igorwolfs/modular-adc-hw/docs/board2board/connectors.md

# Connector types
## JLC Lots in stock
### BM22-65-V
Hirose
- Cheap
- Only 6 connections
- Large availability

### Molex 
- https://jlcpcb.com/partdetail/MOLEX-5052704012/C3024406
- Cheap
- 40 pin connections

### What does stm32 use?
- FTR-130-03-L-D-LC (Samtec)
	- 60 pinheaders
- FTR-120-03-L-D-LC (Samtec)
	- 40 pinheaders

### Butterstick
- Samtec - QSE-020-01-F-D-A
