igorwolfs/modular-adc-hw/simulations/ltspice/blocking_adc_frontend_lcr.asc

C1: cap; {C_P}
C2: cap; {C_P}
C3: cap; {C_H}
C4: cap; {C_H}
C5: cap; {C_P}
C6: cap; {C_P}
C7: cap; {C_block}
C9: cap; {C_block}
C10: cap; {C_H}
C11: cap; {C_H}
C12: cap; {C_filter}
C13: cap; {C_block}
C14: cap; {C_block}
C15: cap; {C_P}
C16: cap; {C_P}
C17: cap; {C_H}
C18: cap; {C_H}
C19: cap; {C_filter}
C20: cap; {C_block}
C21: cap; {C_block}
L3: ind; {{L_filter} + 0.05*{L_filter}}
L4: ind; {{L_filter}-0.05*{L_filter}}
L5: ind; {{L_filter} + 0.05*{L_filter}}
L6: ind; {{L_filter}-0.05*{L_filter}}
R1: res; {R_tl}
R2: res; {R_tl}
R3: res; {{R_diff}/2}
R4: res; {R_diff/2}
R5: res; {R_diff/2}
R6: res; {R_div}
R7: res; {R_div}
R8: res; 100e3
R9: res; 100e3
R12: res; 0.01
R13: res; 0.01
R14: res; {{R_diff}/2}
R15: res; {R_tl}
R16: res; {R_tl}
R17: res; {R_diff/2}
R18: res; {R_diff/2}
R19: res; 100e3
R20: res; 100e3
R21: res; 5
R22: res; 5
R23: res; 0.01
R24: res; 0.01
R25: res; {R_tl}
R26: res; {R_tl}
R27: res; {R_diff/2}
R28: res; {R_diff/2}
R29: res; 100e3
R30: res; 100e3
R31: res; 5
R32: res; 5
R33: res; 0.01
R34: res; 0.01
S1: sw; SW1
S2: sw; SW1
S3: sw; SW1
S4: sw; SW1
S5: sw; SW1
S6: sw; SW1
S7: sw; SW1
S8: sw; SW1
S9: sw; SW1
S10: sw; SW1
S11: sw; SW1
S12: sw; SW1
U1: UniversalOpAmp; Avol=1000 GBW=2e20 Vos=0
U2: UniversalOpAmp; Avol=1000 GBW=2e20 Vos=0
U3: UniversalOpAmp; Avol=1000 GBW=2e20 Vos=0
U4: UniversalOpAmp; Avol=1000 GBW=2e20 Vos=0
U5: UniversalOpAmp; Avol=1000 GBW=2e20 Vos=0
U6: UniversalOpAmp; Avol=1000 GBW=2e20 Vos=0
V1: voltage; PULSE(0 3.3 0 2.14e-9 2.14e-9 10e-9 28.57e-9 1e6)
V2: voltage; PULSE(3.3 0 0 2.14e-9 2.14e-9 10e-9 28.57e-9 1e6)
V3: voltage; SINE(0 1.5 1e6 0 0 0 1e6); AC 1 0; Rser=0
V4: voltage; 3.3
Named nets: AIN+, AIN-, 0, V_IN_SW, V_SHA_SW, V_bias, VREF
.param C_P=5e-9 C_H=5e-9 t_rf=2.14e-9 tch=100e-9 C_block=100e-9 R_diff=10 R_tl=1 R_div=4.7e3 L_filter=1pH C_filter=100pF
.tran 0 10e-6 0 1e-10
CLK_LOW:
- SW1, SW2: closed, SW3: open
- Ch is charged
CLK LOW->HIGH:
- SW1, SW2: opened, SW3: closed
- SHA in HOLD mode
a few moments later
- SW3 closed
- Amplifier output == CH voltage
.model SW1 SW(Ron=50 Roff=1e9 Vt=1.5 Vh=0)
Ideal buffering OPAMP 
- SHORT between 2 inputs
- infinite input impedance
Note: in order to buffer a differential signals we need 2 buffers
Input impedance for next stage
.ac oct 1e3 1e3 15e6
NOTES ON DIFFERENTIAL VS SINGLE-ENDED FILTERS
Differential filter
- differential impedance Zd(f) (to differential component: Vd = V+ - V-)
- common mode impedance infinity (to common-mode component (V+ + V-) / 2) 
- So the filter acts purely on the differential mode.
- Ground variations only affect common-mode voltage, not the filtered differential voltage
Single-ended filter
- Filters signal w.r.t. ground -> single-ended signals take this path back to source.
- Stray currents can change the filter's behavior and the line voltage
