igorwolfs/modular-adc-hw/simulations/ltspice/ths4521.asc

C1: cap; {C_FB}
C2: cap; {C_FB}
C3: cap; 0.1µ
R1: res; {R_FRONT}
R2: res; {R_FRONT}
R4: res; {R_LOAD}
R5: res; {R_FB}
R7: res; 100k
R8: res; 100k
R9: res; 50
R10: res; {R_FB}
R11: res; 50
R12: res; {R_OUT}
R13: res; {R_LOAD}
R14: res; {R_OUT}
U1: THS4521
V1: voltage; 1.4
V3: voltage; SINE(0 0.6 1e5 0 0 0 1e6); AC 0.7 0; Rser=0
V4: voltage; 3.3
V6: voltage; 1.45
Named nets: AIN+, AIN-, 0, VREF, VBIAS
.tran 0 1e-5 0 1e-10
.ac oct 1e3 1e3 15e6
.param C_FB=1.5nF R_FB=1k R_FRONT=1k R_OUT=50 C_OUT=2.2nF R_LOAD=100k V_CM=1.45 V_DIFF=0.6
- Input/Output ([Vs-] - 0.7V)-> ([Vs+] + 0.7)
- Vid_max = 1 V
SOURCES:
- Using differential sources in ltspice: https://www.youtube.com/watch?v=o5SBtzoKLpM
