igorwolfs/modular-adc-hw/modular-adc-board/modular-adc-board.kicad_pcb

## KiCad design modular-adc-board/modular-adc-board.kicad_pcb (2025-09-30)

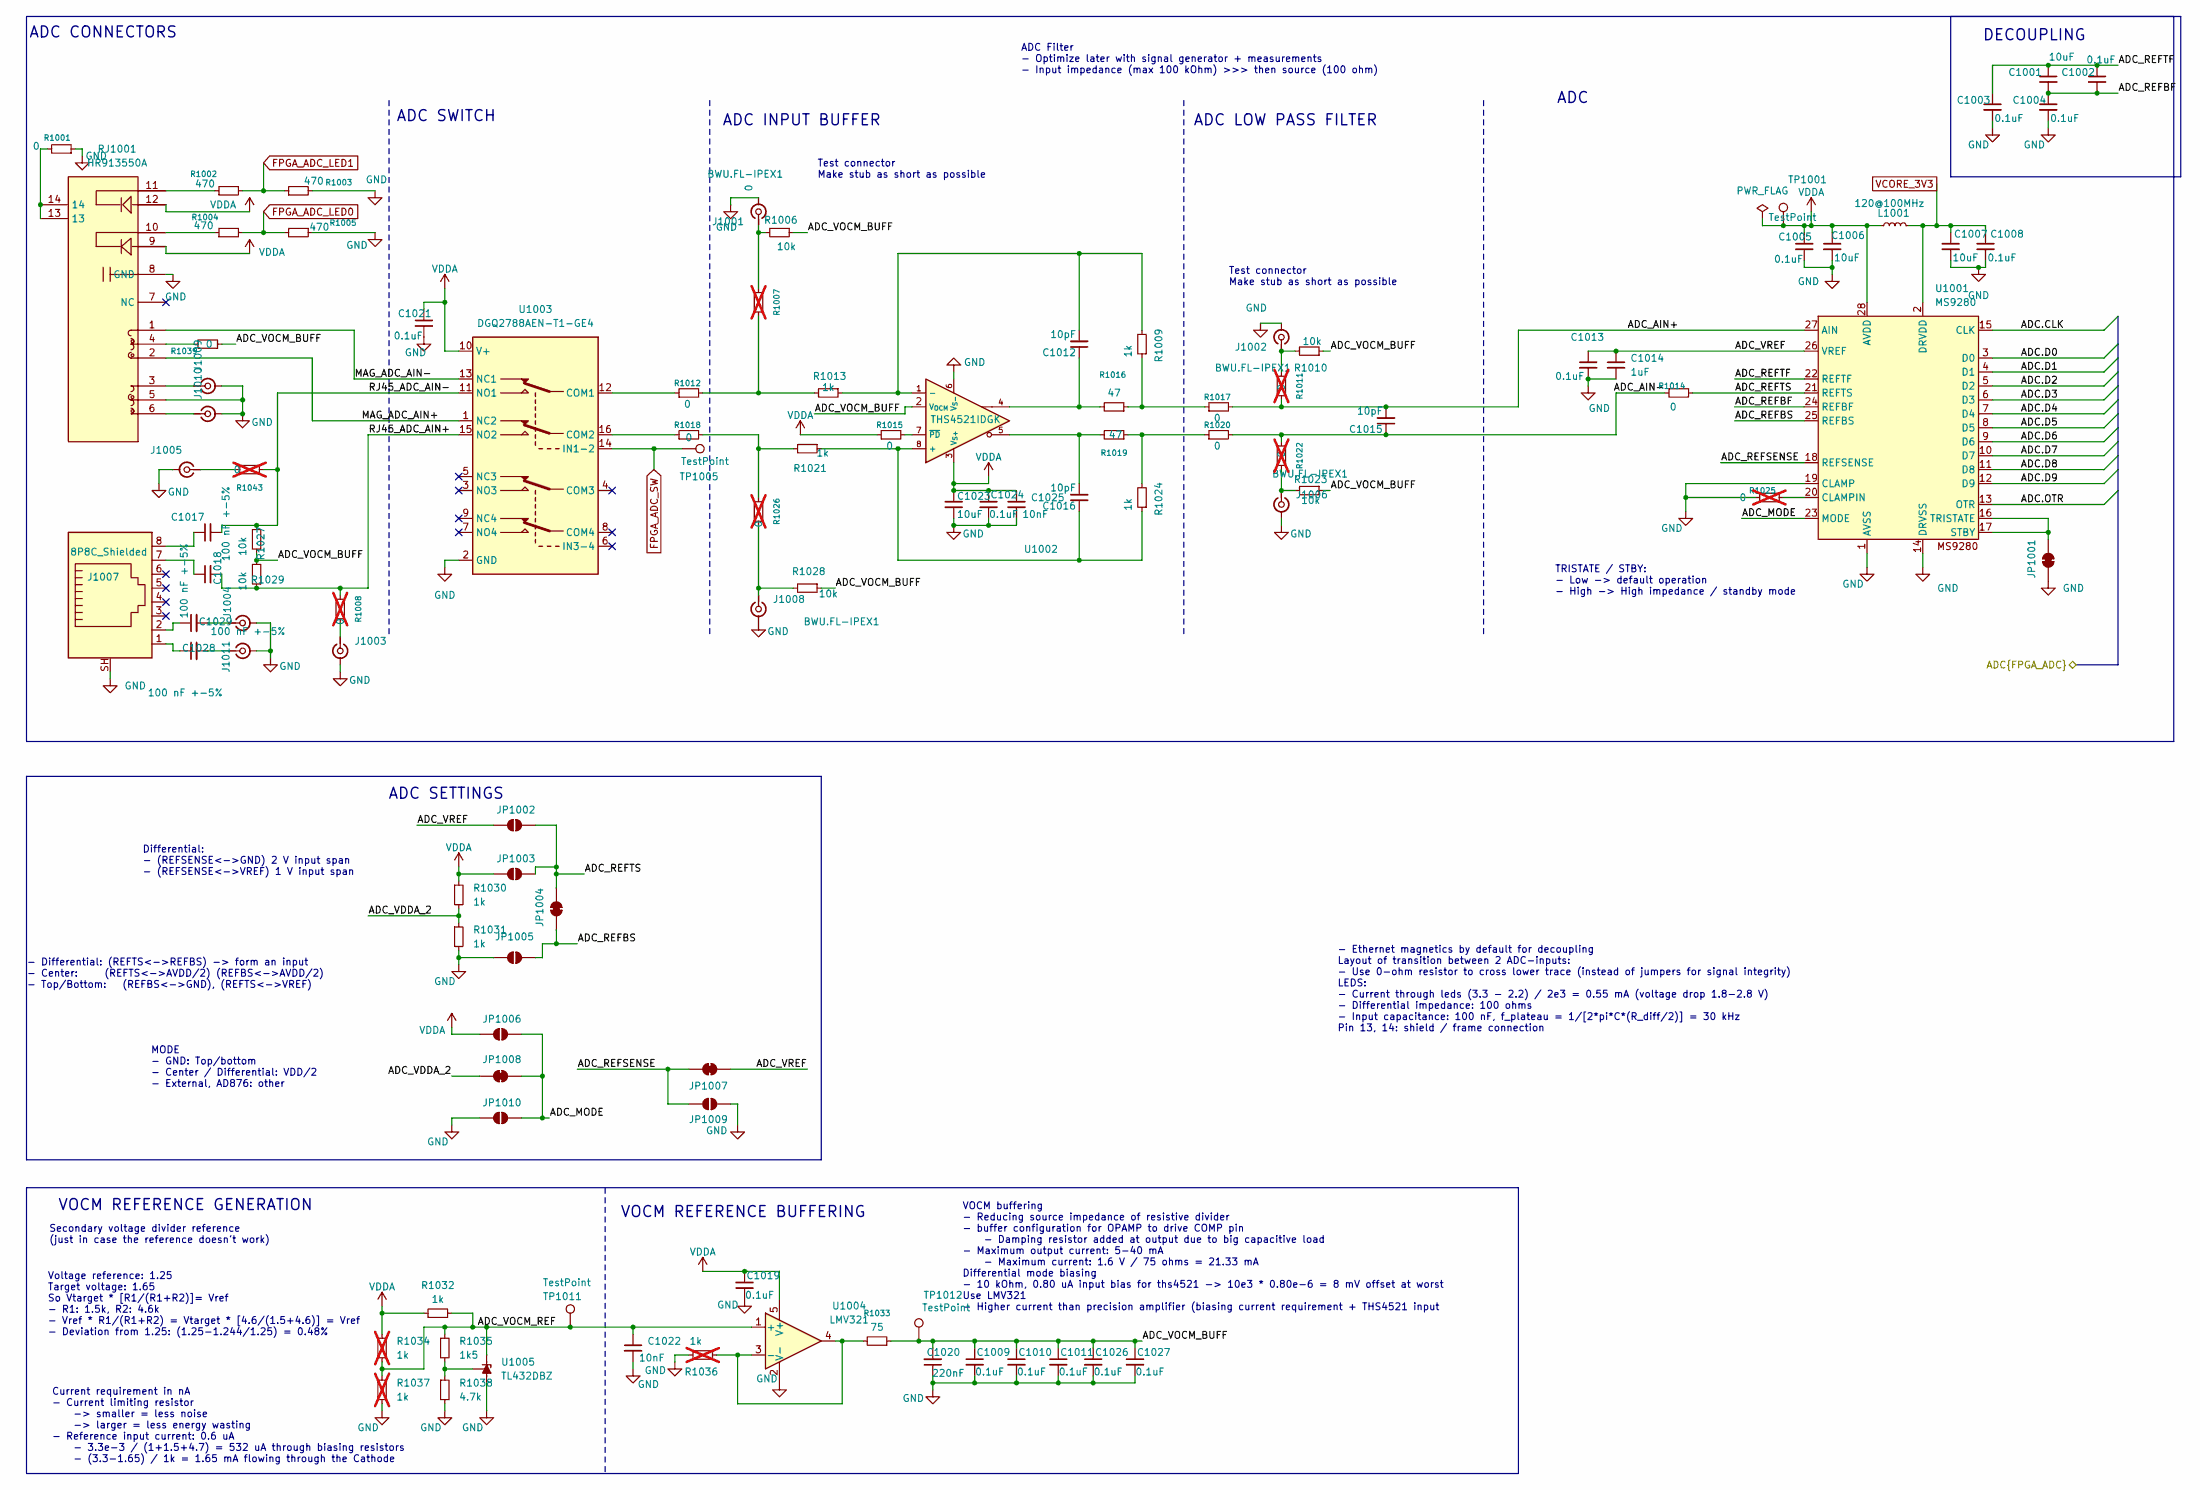
[picture p1: schematic analog-frontend.kicad_sch]

Parts:
C1001, C1006, C1007, C1023: 10uF; C_0603_1608Metric; Manufacturing Part Numb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 CL10A106KP8NNNC; LCSC Part Number C19702
C1002, C1003, C1004, C1005, C1008, C1009, C1010, C1011, C1013, C1019, C1021, C1024, C1026, C1027: 0.1uF; C_0201_0603Metric; Manufacturing Part Numb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 CGA0201X7R104K160ET; LCSC Part Number C22435929
C1012, C1015, C1016: 10pF; C_0603_1608Metric_Pad1.08x0.95mm_HandSolder; Manufacturing Part Numb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 CL10C100JB8NNNC; LCSC Part Number C1634
C1014: 1uF; C_0805_2012Metric; Manufacturing Part Numb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 CL21B105KBFNNNE; LCSC Part Number C28323
C1017, C1018, C1028, C1029: 100 nF +-5%; C_0603_1608Metric_Pad1.08x0.95mm_HandSolder; Manufacturing Part Numb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 0603B104J500NT; LCSC Part Number C88136
C1020: 220nF; C_0402_1005Metric; Manufacturing Part Numb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 CL05B224KO5NNNC; LCSC Part Number C16772
C1022, C1025: 10nF; C_0201_0603Metric; Manufacturing Part Numb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 0201B103K250NT; LCSC Part Number C285010
J1001, J1002, J1003, J1004, J1005, J1006, J1008, J1009, J1010, J1011: BWU.FL-IPEX1; Manufacturing Part Numb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 BWU.FL-IPEX1; LCSC Part Number C5137195
J1007: 8P8C_Shielded; RJ45_RCH_RC01937; Manufacturing Part Numb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 RC01937; LCSC Part Number C708652
JP1001, JP1004, JP1007, JP1008: SolderJumper_2_Bridged; SolderJumper-2_P1.3mm_Bridged_Pad1.0x1.5mm
JP1002, JP1003, JP1005, JP1006, JP1009, JP1010: SolderJumper_2_Open; SolderJumper-2_P1.3mm_Open_Pad1.0x1.5mm
L1001: 120@100MHz; L_0603_1608Metric; Manufacturing Part Numb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 UPB160805T-121Y-N; LCSC Part Number C285595
R1001: 0; R_0603_1608Metric_Pad0.98x0.95mm_HandSolder; Manufacturing Part Numb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 0603WAF0000T5E; LCSC Part Number C21189
R1002, R1003, R1004, R1005: 470; R_0603_1608Metric; Manufacturing Part Numb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 0603WAF4700T5E; LCSC Part Number C23179
R1006, R1010, R1023, R1027, R1028, R1029: 10k; R_0603_1608Metric; Manufacturing Part Numb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 0603WAF1002T5E; LCSC Part Number C25804
R1007, R1008, R1011, R1022, R1025, R1026, R1043: 0; R_0603_1608Metric; Manufacturing Part Numb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 0603WAF0000T5E; LCSC Part Number C21189; not fitted
R1009, R1013, R1021, R1024, R1030, R1031, R1032: 1k; R_0603_1608Metric; Manufacturing Part Numb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 0603WAF1001T5E; LCSC Part Number C21190
R1012, R1015, R1017, R1018, R1020: 0; R_0402_1005Metric_Pad0.72x0.64mm_HandSolder; Manufacturing Part Numb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 0402WGF0000TCE; LCSC Part Number C17168
R1014, R1039: 0; R_0603_1608Metric; Manufacturing Part Numb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 0603WAF0000T5E; LCSC Part Number C21189
R1016, R1019: 47; R_0603_1608Metric; Manufacturing Part Numb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 0603WAF470JT5E; LCSC Part Number C23182
R1033: 75; R_0603_1608Metric; Manufacturing Part Numb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 0603WAF750JT5E; LCSC Part Number C4275
R1034, R1036, R1037: 1k; R_0603_1608Metric; Manufacturing Part Numb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 C21190; LCSC Part Number 0603WAF1001T5E; not fitted
R1035: 1k5; R_0603_1608Metric; Manufacturing Part Numb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 0603WAF1501T5E; LCSC Part Number C22843
R1038: 4.7k; R_0603_1608Metric; Manufacturing Part Numb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 0603WAF4701T5E; LCSC Part Number C23162
RJ1001: HR913550A; RJ45-TH_HR913550A; Manufacturing Part Numb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 HR913550A; LCSC Part Number C163507
TP1001, TP1011, TP1012: TestPoint; TestPoint_Loop_D1.80mm_Drill1.0mm_Beaded
TP1005: TestPoint; TestPoint_THTPad_1.5x1.5mm_Drill0.7mm
U1001: MS9280; SSOP-28_5.3x10.2mm_P0.65mm; Manufacturing Part Numb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 MS9280; LCSC Part Number C1509021
U1002: THS4521IDGK; VSSOP-8_3x3mm_P0.65mm; Manufacturing Part Numb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 THS4521IDGKR; LCSC Part Number C170157
U1003: DGQ2788AEN-T1-GE4; QFN40P260X180X60-16N_Fv1.2; Manufacturing Part Numb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 DGQ2788AEN-T1-GE4; LCSC Part Number C2673179
U1004: LMV321; SOT-23-5; Manufacturing Part Numb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 LMV321IDBVR; LCSC Part Number C7972
U1005: TL432DBZ; SOT-23; Manufacturing Part Numb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 TL432; LCSC Part Number C5184435

Connections:
/analog-frontend/ADC.CLK: U1001.15 (CLK)
/analog-frontend/ADC.D0: U1001.3 (D0)
/analog-frontend/ADC.D1: U1001.4 (D1)
/analog-frontend/ADC.D2: U1001.5 (D2)
/analog-frontend/ADC.D3: U1001.6 (D3)
/analog-frontend/ADC.D4: U1001.7 (D4)
/analog-frontend/ADC.D5: U1001.8 (D5)
/analog-frontend/ADC.D6: U1001.9 (D6)
/analog-frontend/ADC.D7: U1001.10 (D7)
/analog-frontend/ADC.D8: U1001.11 (D8)
/analog-frontend/ADC.D9: U1001.12 (D9)
/analog-frontend/ADC.OTR: U1001.13 (OTR)
/analog-frontend/ADC_AIN+: C1015.2, R1011.1, R1017.2, U1001.27 (AIN)
/analog-frontend/ADC_AIN-: C1015.1, R1014.1, R1020.2, R1022.1
/analog-frontend/ADC_MODE: JP1006.2 (B), JP1008.2 (B), JP1010.2 (B), U1001.23 (MODE)
/analog-frontend/ADC_REFBF: C1001.2, C1002.2, C1004.1, U1001.24 (REFBF)
/analog-frontend/ADC_REFBS: JP1004.1 (A), JP1005.2 (B), U1001.25 (REFBS)
/analog-frontend/ADC_REFSENSE: JP1007.2 (B), JP1009.2 (B), U1001.18 (REFSENSE)
/analog-frontend/ADC_REFTF: C1001.1, C1002.1, C1003.1, U1001.22 (REFTF)
/analog-frontend/ADC_REFTS: JP1002.2 (B), JP1003.2 (B), JP1004.2 (B), R1014.2, U1001.21 (REFTS)
/analog-frontend/ADC_VDDA_2: JP1008.1 (A), R1030.2, R1031.1
/analog-frontend/ADC_VOCM_BUFF: C1009.1, C1010.1, C1011.1, C1020.2, C1026.1, C1027.1, R1006.1, R1010.1, R1023.1, R1027.1, R1028.1, R1029.2, R1033.1, R1039.1, TP1012.1, U1002.2 (V_{OCM})
/analog-frontend/ADC_VOCM_REF: C1022.1, R1032.2, R1034.2, R1035.1, R1037.1, TP1011.1, U1004.1 (+), U1005.2 (K)
/analog-frontend/ADC_VREF: C1013.1, C1014.1, JP1002.1 (A), JP1007.1 (A), U1001.26 (VREF)
/analog-frontend/MAG_ADC_AIN+: RJ1001.2, U1003.1 (NC2)
/analog-frontend/MAG_ADC_AIN-: RJ1001.1, U1003.13 (NC1)
/analog-frontend/RJ45_ADC_AIN+: C1018.2, R1008.1, R1029.1, U1003.15 (NO2)
/analog-frontend/RJ45_ADC_AIN-: C1017.2, R1027.2, R1043.1, U1003.11 (NO1)
FPGA_ADC_LED0: R1004.2, R1005.2
FPGA_ADC_LED1: R1002.2, R1003.1
FPGA_ADC_SW: TP1005.1, U1003.14 (IN1-2)
GND: C1003.2, C1004.2, C1005.2, C1006.2, C1007.2, C1008.2, C1009.2, C1010.2, C1011.2, C1013.2, C1014.2, C1019.2, C1020.1, C1021.2, C1022.2, C1023.2, C1024.2, C1025.2, C1026.2, C1027.2, J1001.2 (Ext), J1002.2 (Ext), J1003.2 (Ext), J1004.2 (Ext), J1005.2 (Ext), J1006.2 (Ext), J1007.SH, J1008.2 (Ext), J1009.2 (Ext), J1010.2 (Ext), J1011.2 (Ext), JP1001.1 (A), JP1005.1 (A), JP1009.1 (A), JP1010.1 (A), R1001.1, R1003.2, R1005.1, R1025.1, R1031.2, R1036.1, R1037.2, R1038.2, RJ1001.5, RJ1001.8 (GND), U1001.1 (AVSS), U1001.14 (DRVSS), U1001.19 (CLAMP), U1002.6 (V_{S-}), U1003.2 (GND), U1004.2 (V-), U1005.3 (A)
unnamed: C1012.1, R1016.2, U1002.4
unnamed: C1016.2, R1019.2, U1002.5
unnamed: C1017.1, J1007.8
unnamed: C1018.1, J1007.7
unnamed: C1028.1, J1007.1
unnamed: C1029.1, J1007.2
unnamed: J1001.1 (In), R1006.2, R1007.1
unnamed: J1002.1 (In), R1010.2, R1011.2
unnamed: J1003.1 (In), R1008.2
unnamed: C1029.2, J1004.1 (In)
unnamed: J1005.1 (In), R1043.2
unnamed: J1006.1 (In), R1022.2, R1023.2
unnamed: J1008.1 (In), R1026.2, R1028.2
unnamed: J1009.1 (In), RJ1001.3
unnamed: J1010.1 (In), RJ1001.6
unnamed: C1028.2, J1011.1 (In)
unnamed: JP1001.2 (B), U1001.16 (TRISTATE), U1001.17 (STBY)
unnamed: R1001.2, RJ1001.13, RJ1001.14
unnamed: R1002.1, RJ1001.11
unnamed: R1004.1, RJ1001.10
unnamed: R1007.2, R1012.2, R1013.2
unnamed: R1009.1, R1016.1, R1017.1
unnamed: R1018.2, R1021.2, R1026.1
unnamed: R1019.1, R1020.1, R1024.2
unnamed: R1039.2, RJ1001.4
unnamed: R1025.2, U1001.20 (CLAMPIN)
unnamed: C1016.1, R1021.1, R1024.1, U1002.8 (+)
unnamed: C1012.2, R1009.2, R1013.1, U1002.1 (-)
unnamed: R1015.2, U1002.7 (~PD)
unnamed: R1012.1, U1003.12 (COM1)
unnamed: R1018.1, U1003.16 (COM2)
unnamed: R1033.2, R1036.2, U1004.3 (-), U1004.4
unnamed: R1035.2, R1038.1, U1005.1 (REF)
VCORE_3V3: C1007.1, C1008.1, L1001.1, U1001.2 (DRVDD)
VDDA: C1005.1, C1006.1, C1019.1, C1021.1, C1023.1, C1024.1, C1025.1, JP1003.1 (A), JP1006.1 (A), L1001.2, R1015.1, R1030.1, R1032.1, R1034.1, RJ1001.9, RJ1001.12, TP1001.1, U1001.28 (AVDD), U1002.3 (V_{S+}), U1003.10 (V+), U1004.5 (V+)

Notes on the sheet:
ADC CONNECTORS
ADC SETTINGS
VOCM REFERENCE BUFFERING
Test connector Make stub as short as possible
ADC INPUT BUFFER
VOCM REFERENCE GENERATION
ADC Filter - Optimize later with signal generator + measurements - Input impedance (max 100 kOhm) >>> then source (100 ohm)
Secondary voltage divider reference (just in case the reference doesn't work)
TRISTATE / STBY: - Low -> default operation - High -> High impedance / standby mode
DECOUPLING
Current requirement in nA - Current limiting resistor -> smaller = less noise -> larger = less energy wasting - Reference input current: 0.6 uA - 3.3e-3 / (1+1.5+4.7) = 532 uA through biasing resistors - (3.3-1.65) / 1k = 1.65 mA flowing through the Cathode
ADC SWITCH
VOCM buffering - Reducing source impedance of resistive divider - buffer configuration for OPAMP to drive COMP pin - Damping resistor added at output due to big capacitive load - Maximum output current: 5-40 mA - Maximum current: 1.6 V / 75 ohms = 21.33 mA Differential mode biasing - 10 kOhm, 0.80 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
Differential: - (REFSENSE<->GND) 2 V input span - (REFSENSE<->VREF) 1 V input span
MODE - GND: Top/bottom - Center / Differential: VDD/2 - External, AD876: other
- Differential: (REFTS<->REFBS) -> form an input - Center: (REFTS<->AVDD/2) (REFBS<->AVDD/2) - Top/Bottom: (REFBS<->GND), (REFTS<->VREF)
Voltage reference: 1.25 Target voltage: 1.65 So Vtarget * [R1/(R1+R2)]= Vref - R1: 1.5k, R2: 4.6k - Vref * R1/(R1+R2) = Vtarget * [4.6/(1.5+4.6)] = Vref - Deviation from 1.25: (1.25-1.244/1.25) = 0.48%
- Ethernet magnetics by default for decoupling Layout of transition between 2 ADC-inputs: - Use 0-ohm resistor to cross lower trace (instead of jumpers for signal integrity) LEDS: - Current through leds (3.3 - 2.2) / 2e3 = 0.55 mA (voltage drop 1.8-2.8 V) - Differential impedance: 100 ohms - Input 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
ADC
ADC LOW PASS FILTER

Board: 2 copper layers, 101 parts (0 on the bottom side), 55 nets, no tracks yet.
