igorwolfs/modular-adc-hw/docs/todo.md

# TODO
- Test ADC on old board (desolder, resolder input wires and check input signal)
